baochip/dabao/README.md

# Dabao board design files

This repo contains the Kicad design files for the Dabao evaluation board for the Baochip-1x.
