baochip/dabao/dabao_v3c.pdf

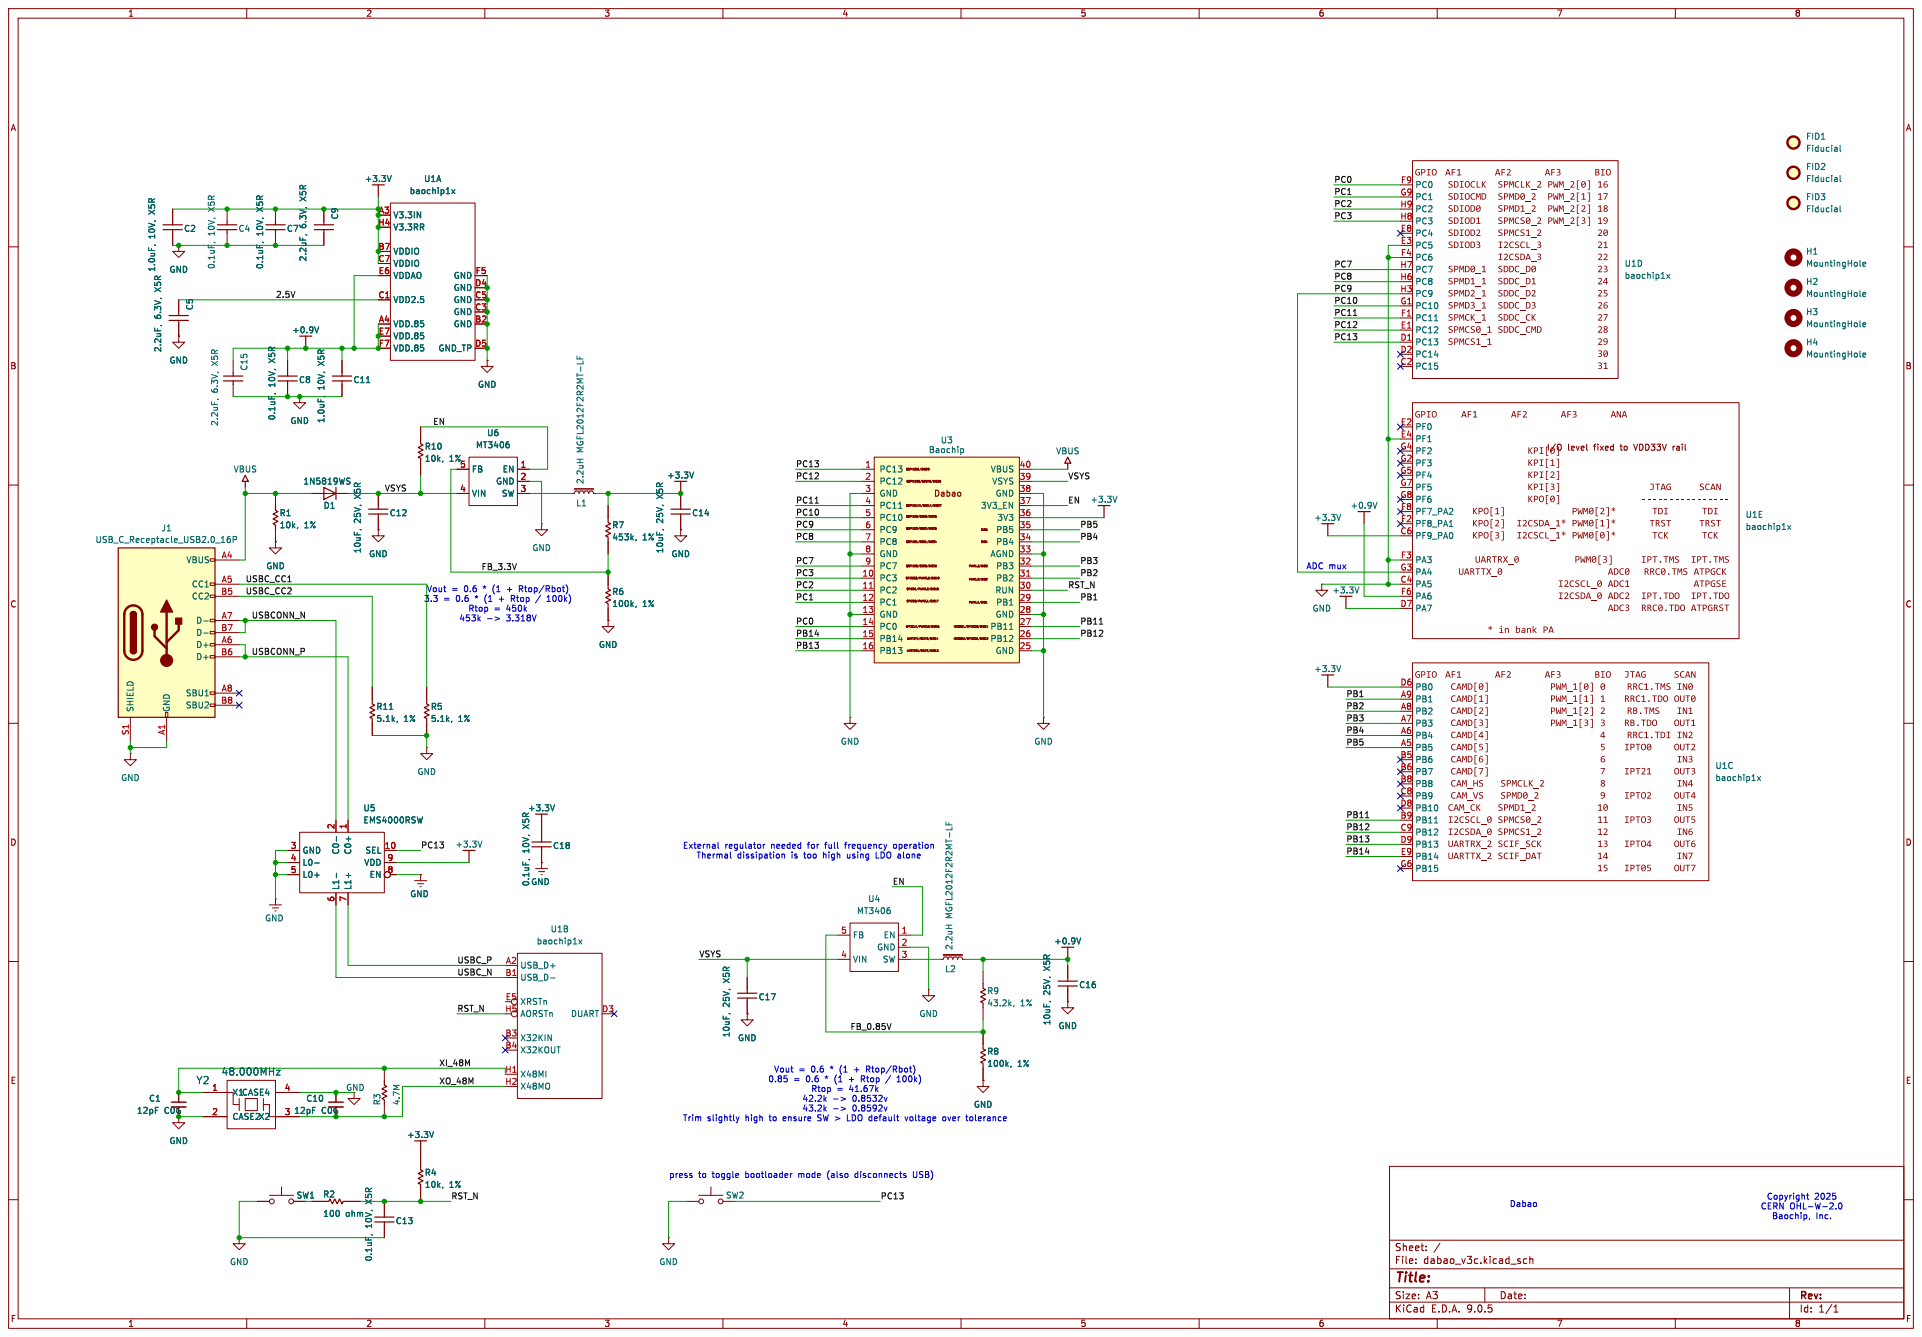
[picture p1: page 1]

3V3 36 PB5 35 PB4 34 AGND 33 PB3 32 PB2 31 RUN 30 PB1 29 GND 28 PB11 27 PB12 26 GND 25 U3 Baochip VSYS USBCONN_P USBCONN_N

IPT.TMS

IPT.TDO

Vout = 0.6 * (1 + Rtop/Rbot) 3.3 = 0.6 * (1 + Rtop / 100k)
