baochip/dabao/(commit log)

2025-10-30 update v3b files
    [dabao_v3b.kicad_pcb, dabao_v3b.kicad_sch]
2025-11-04 add artifacts required for USB ID
    [bom.csv, dabao_v3b.kicad_sch, positions.csv]
2025-11-10 update to v3c
    fix USB-CC resistor issue and improve thermal/electrical
    performance on chip power pins
    [bom.csv, dabao_v3c.kicad_pcb, dabao_v3c.kicad_sch, positions.csv]
2025-11-10 remove old files
    [dabao_v3b.kicad_pcb, dabao_v3b.kicad_sch]
2025-11-10 update silkscreen and add step file
    [dabao_v3c.kicad_pcb]
2025-11-17 update routing to latest rev
    [dabao_v3c.kicad_pcb]
2025-11-17 add usb pads on the back side
    allows for pogo testing & also possibly SMT access to USB
    board designers will have to exercise caution tho - 480Mbps won't
    tolerate a lot of shenanigans in layout.
    [dabao_v3c.kicad_pcb, dabao_v3c.kicad_sch]
